MolkEmbedded/MarsRover3/Images/20160609_095637.jpg

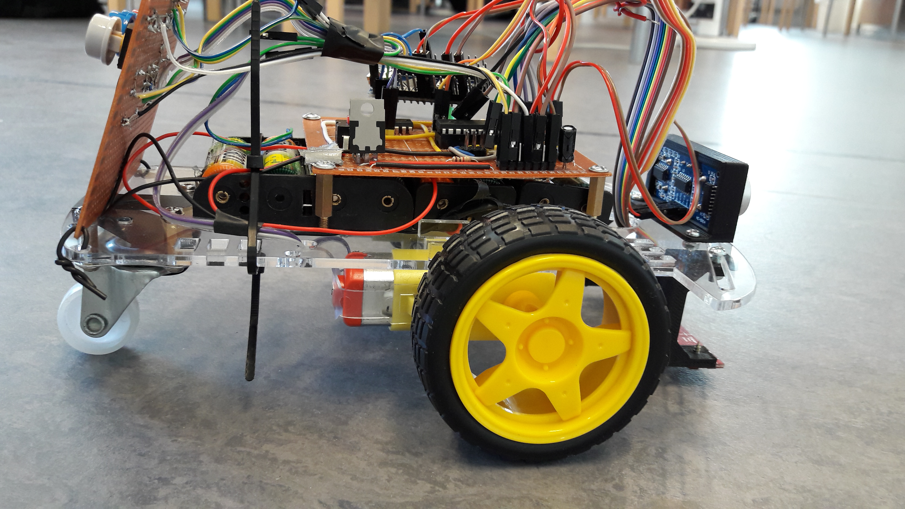
Images/20160609_095637.jpg
