MolkEmbedded/MarsRover3/Images/20160609_095617.jpg

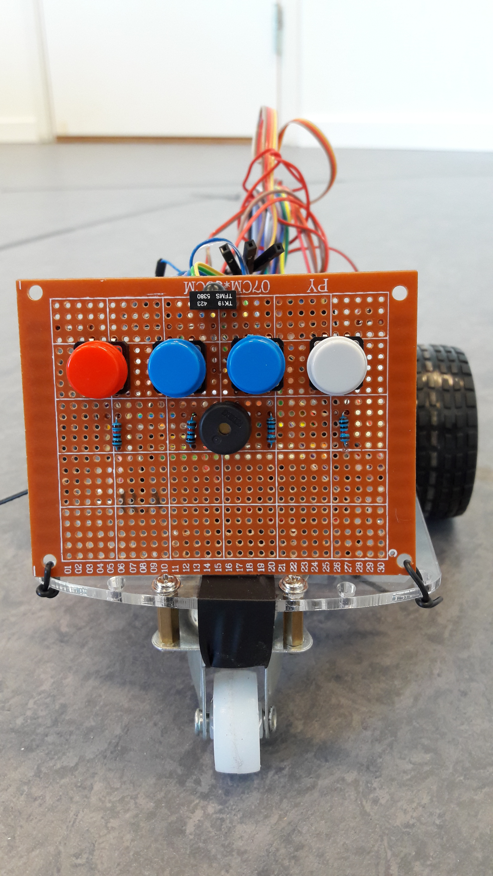
Images/20160609_095617.jpg
