MolkEmbedded/MarsRover3/documents/MarsRover3.pptx

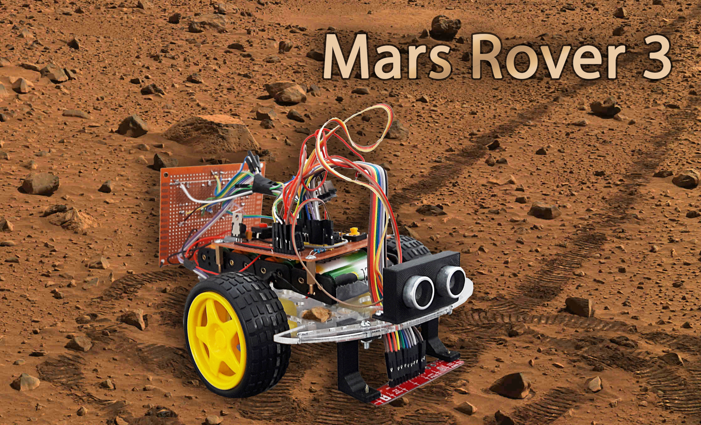
[picture p3: figure]

## Mars Rover 3

Emil Engström | Projektledare
Martin Bäckström | Styrsystem
Marcus Johansson | Styrsystem
Björn Svensson | Menysystem
Johan Skog | Menysystem
Abdul Khadir Hussein | Menysystem
Hans Winzell | Styrsystem, hårdvara

## Ingående delar

Robotplattform ink hjul och motorer
IR-sensormodul
2st Atmega328P
Ultrasonic Sensor HC-SR04
H-brygga
Buzzer
Knappar
Display

## Problem

I²C - TWI
Stödhjul
PID-regleringen
PWM och in- och utgångarna

## Slutsats

Roligt
Lärorikt
