MolkEmbedded/MarsRover3/documents/graphics/mainboard.jpg

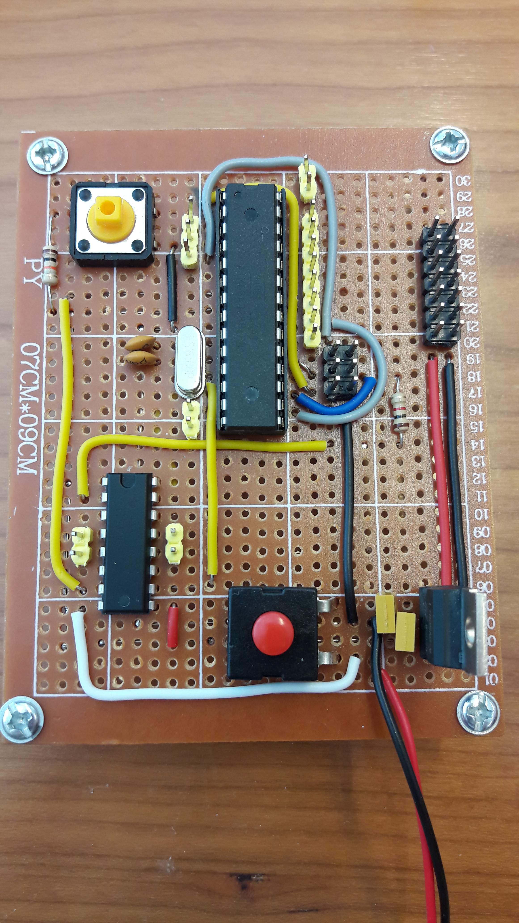
documents/graphics/mainboard.jpg
