MolkEmbedded/MarsRover3/Images/20160609_083827.jpg

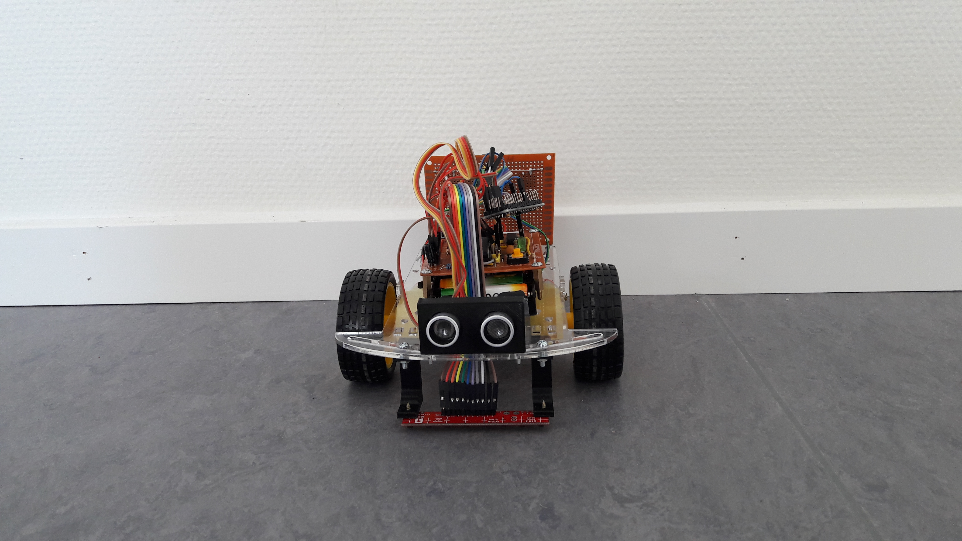
Images/20160609_083827.jpg
