MolkEmbedded/MarsRover3/Images/20160609_083841.jpg

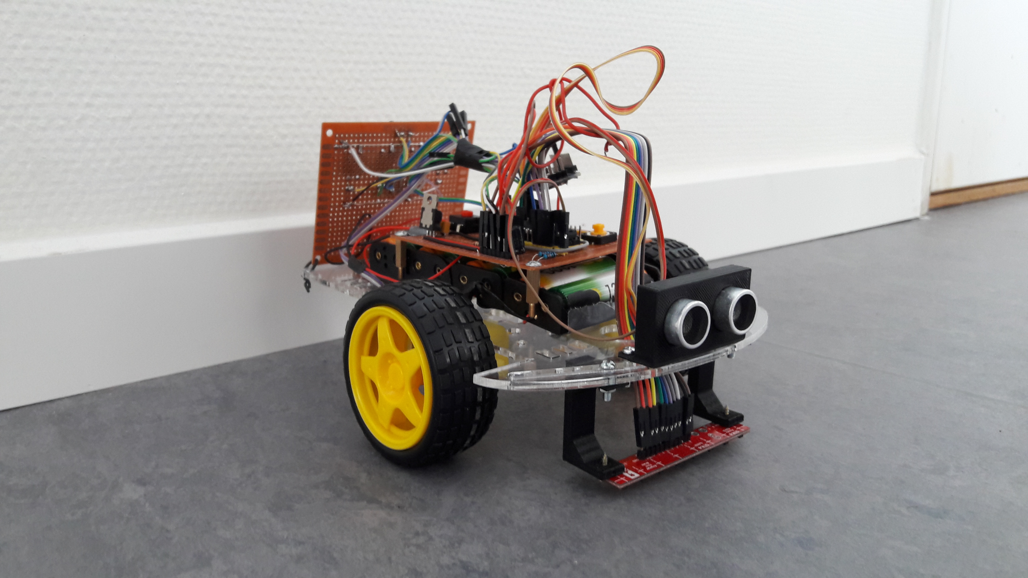
Images/20160609_083841.jpg
