MolkEmbedded/MarsRover3/Images/20160609_083846.jpg

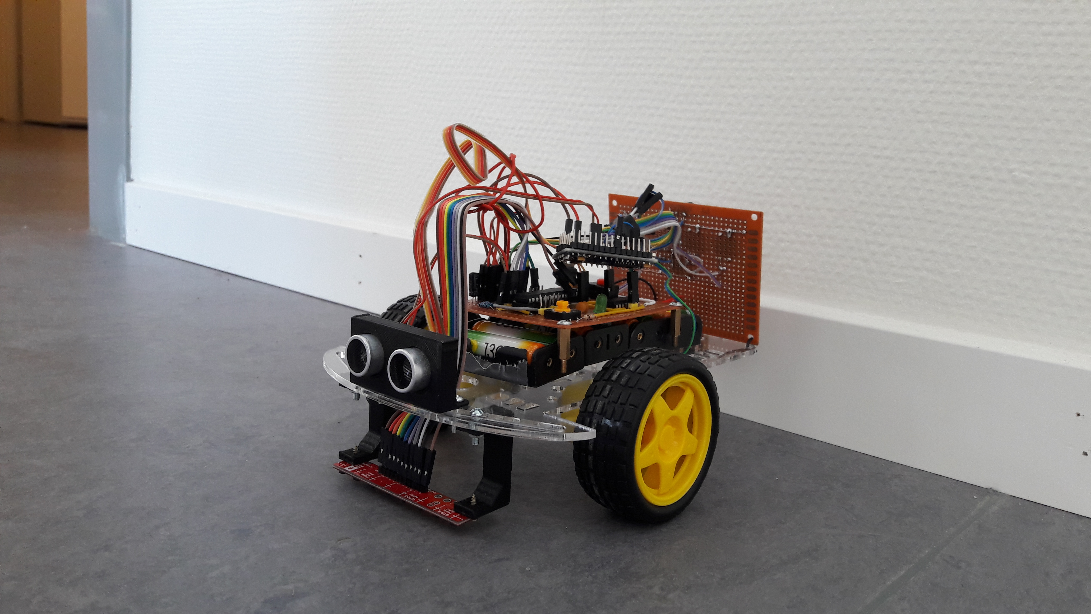
Images/20160609_083846.jpg
