MolkEmbedded/MarsRover3/Images/20160609_083848.jpg

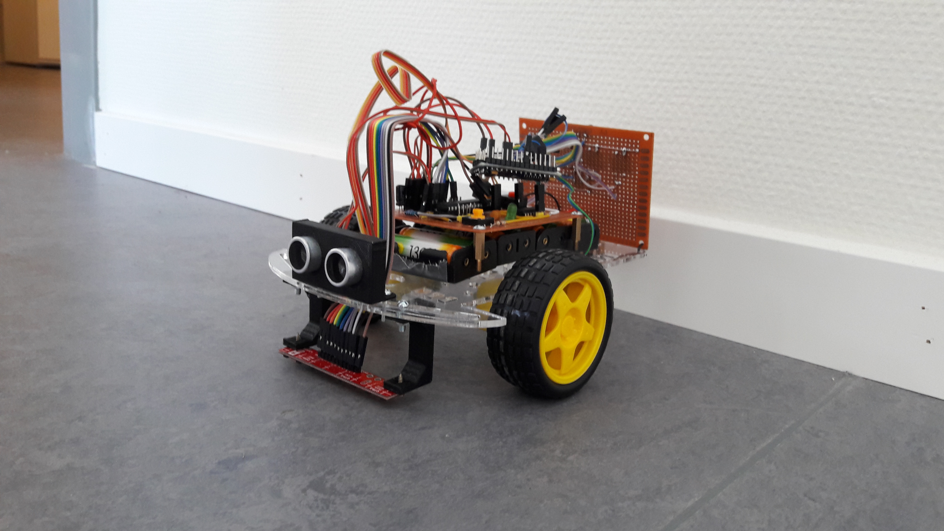
Images/20160609_083848.jpg
