MolkEmbedded/MarsRover3/Images/20160609_095625.jpg

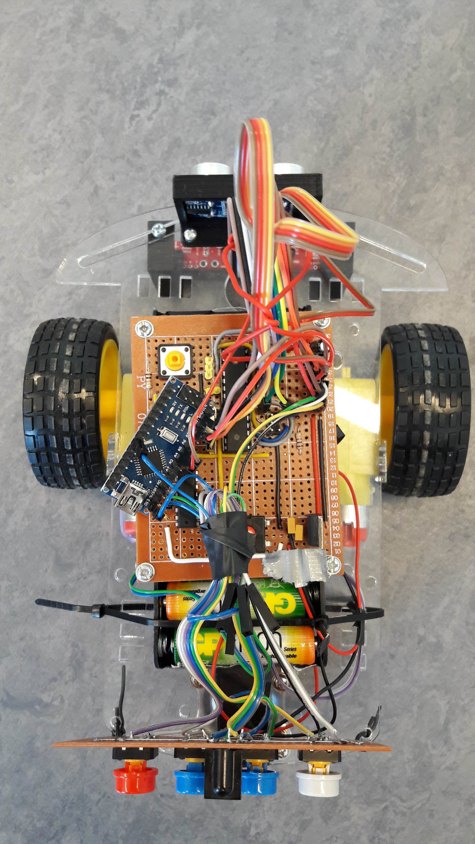
Images/20160609_095625.jpg
