MolkEmbedded/MarsRover3/Images/20160609_095630.jpg

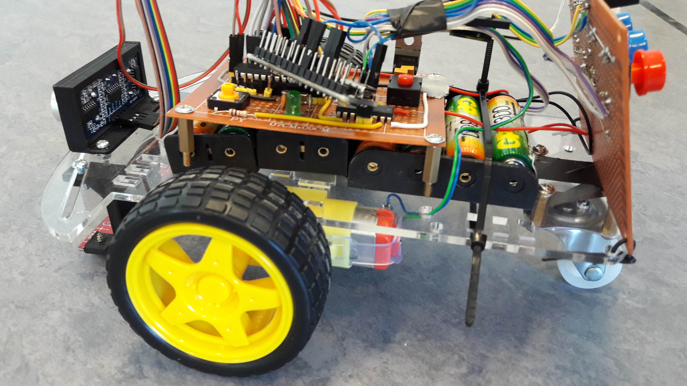
Images/20160609_095630.jpg
