MolkEmbedded/MarsRover3/Images/MarsRoverTracks.jpg

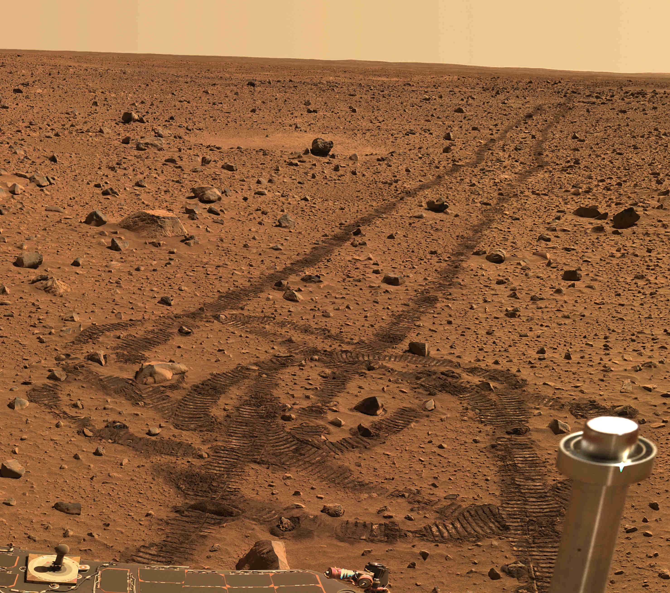
Images/MarsRoverTracks.jpg
