MolkEmbedded/MarsRover3/documents/robot.pdf

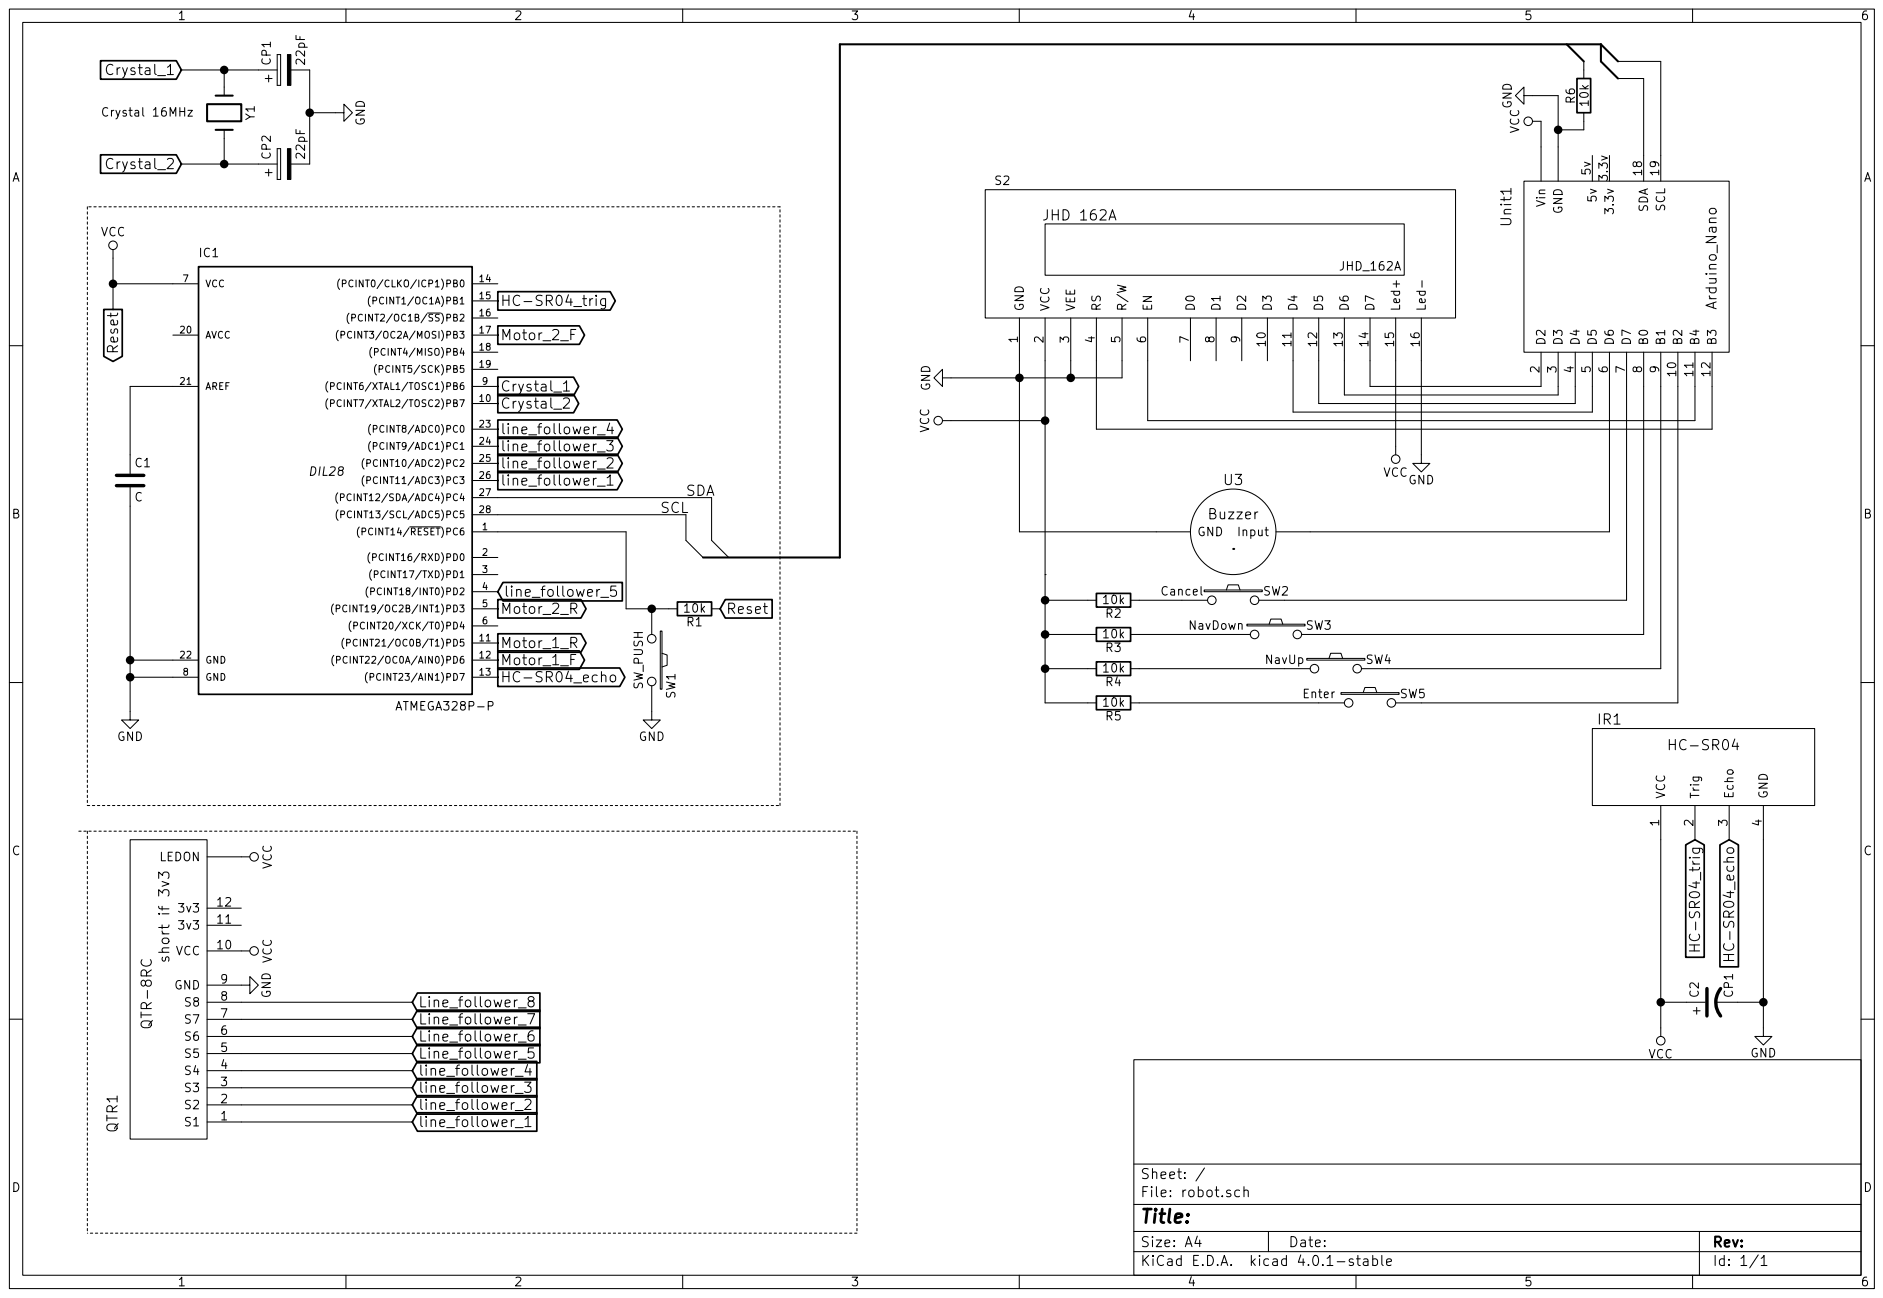
[picture p22: page 1]

Id: 1/1 Title: File: robot.sch Sheet: /
