MolkEmbedded/MarsRover3/code/Slave code 328p/TWI_And_Motors.h

void TWI_InitSlave(void);
void pwmInit();
void dataFunction(unsigned char);
void motorAuto(float);
void motorDance(void);

#define RightF OCR0A 
#define RightR OCR0B 
#define LeftF OCR2A
#define LeftR OCR2B

#define Motor1F OCR0A
#define Motor1R OCR0B
#define Motor2F OCR2A
#define Motor2R OCR2B

#define leftSpeed 115
#define rightSpeed 115
