MolkEmbedded/MarsRover3/(commit log)

2016-04-18 add project.xlsx
    [Projekt.xlsx]
2016-04-18 Autonomous Mode - Flowchart
2016-04-19 Revert "UPDATE"
    This reverts commit cf6b4956c774318a3ed5a3156d401daa29fecb25.
    [Projekt.xlsx]
2016-05-03 Changed pin output for Motor
2016-05-03 Named Motor pins
2016-05-11 Arduino map
2016-05-12 Ultrasonic code
2016-05-16 Arduino kod för IR_R
    Kod sen innan borttagen. Ny kod inlagd
2016-05-23 V1 Master Arduino
2016-05-23 Sonar (Ultrasonic)
2016-05-24 I2C display
2016-05-24 update schematic
2016-05-27 Motor and sensors
2016-05-31 Revert "Working 1.0"
    This reverts commit 0129d9805e8f1152fd6960c7e3a1d7f4e2de31d9.
    [TWI_slave.c, TWI_slave.h, lineSensor.c, lineSensor.h, main.c]
2016-05-31 Motors and sensors 1.0
2016-06-01 update schematic with Nano
2016-06-01 fanfare for buzzer in Arduino
    [fanfare.ino]
2016-06-01 Pull up, I2C - schematic
2016-06-07 code for testing PID
2016-06-08 Changed pins on line follower - schematics
2016-06-08 update sensortext
2016-06-08 stavfel i IR sensor
2016-06-09 Added arduino code
