MolkEmbedded/MarsRover3/(notices)

Notices in the files:
code/Slave code 328p/sonar.h:
LICENSE : Redistribution and use in source and/or binary forms, with or without modification,
are permitted provided that the following conditions are met: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
